Linnea030/Cat_Catering_Machine/Miniproject-Yixin Cao.pdf

## B31DD Report – Mini Project- Cat Catering Machine

Student Name: Yixin Cao
Student Number: H00315680

### 1.0 Project introduction

At present, young people are often too busy working overtime to take care of their pets. And in a long trip inconvenient to take the cat, will throw a lot of food. The grain is thus susceptible to damp spoilage. Cats get sick, too. Hence, young people do not have enough time to take care of their pets due to busy work and other reasons, so I developed an Arduino-based cat catering machine. There is timing feeder, and a toy module to the feeder, which can fully help owners to play with their pets. The whole project has four modes.

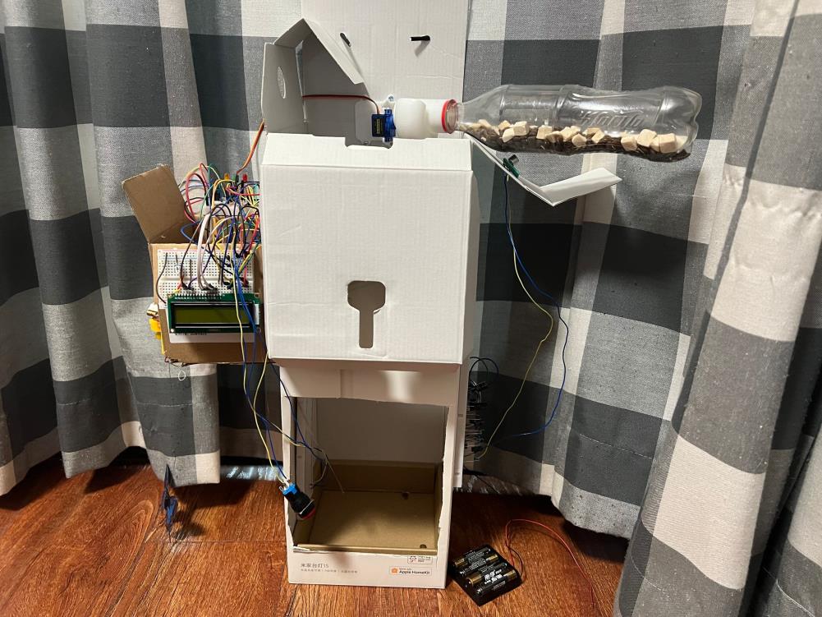
[picture p1: figure]

Figure 1 Machine structure overall
Here some components are needed, such as Arduino, motor, servo, and so on. Besides, there are some modules that did not used in class, such as LM393 and laser.

Table 1 Components used
Components | Number
Arduino uno | 1
Jumper | ∞
Motor | 1
laser | 3
L293D | 1
resister | 2
16*2LCD | 1

switch | 2
Breadboard | 4
Servo | 1
LM393 Soil moisture detection | 1
3D Print items | 2

### 2.0 Functionalities

There are four modes of this machine. The First mode is the playing mode, which is selected according to the pet's toy preferences (After investigation found that many cats and dogs like to chase laser). And because cats and dogs have the nature of hunting, so that this mode also have a module of flying butterfly which can help them train the skills of hunting. This little butterfly is connected to the motor by a wire, and we can use a potentiometer to adjust the speed of the motor and a button to control the direction of rotation. When the motor starts, the module appears to have a small butterfly flying around the device. The module has three laser generators that then shoot lasers at the ground at intervals of 1 seconds to 1s, because the laser is random, it can fully achieve the purpose of playing with pets.

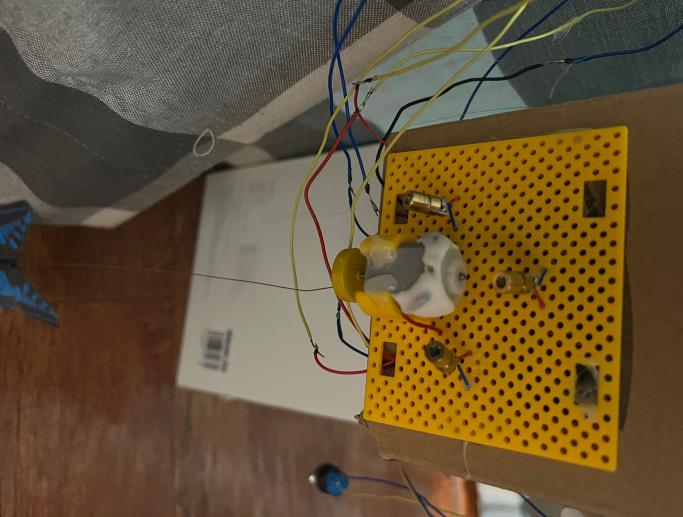
[picture p2: figure]

Figure 2 Assembled pattern for modeA

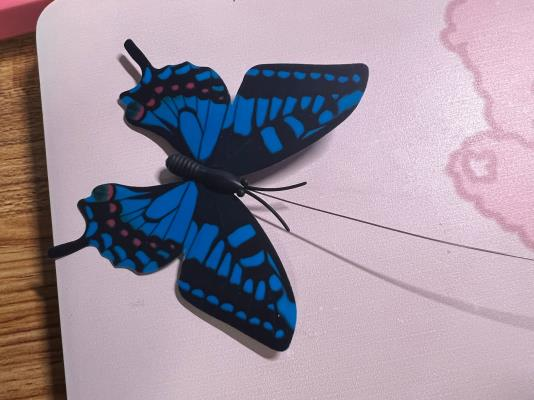
[picture p3: figure]
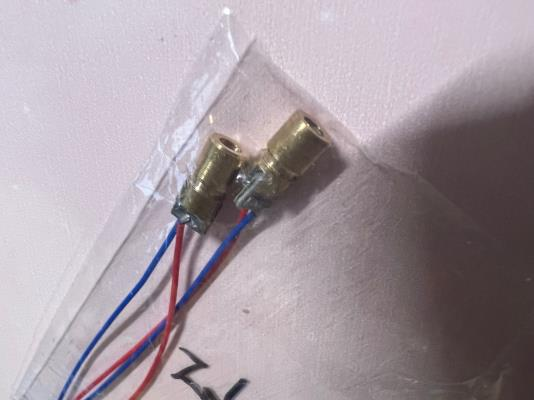
[picture p4: figure]

Figure 3 Toys and laser
The second mode is the feeding mode, which can feed the pets at a fixed time every day. Here are 4 time period can be set, that is, one hour, two hours, three hours and four hours. For convenience, here timer is set 1s instead of 1 hour. You can set the interval time for the feeding module to feed food at regular intervals, the specified interval is 1h, 2h, 3h and 4h, and the set time will be displayed on the 16*2 LCD screen.

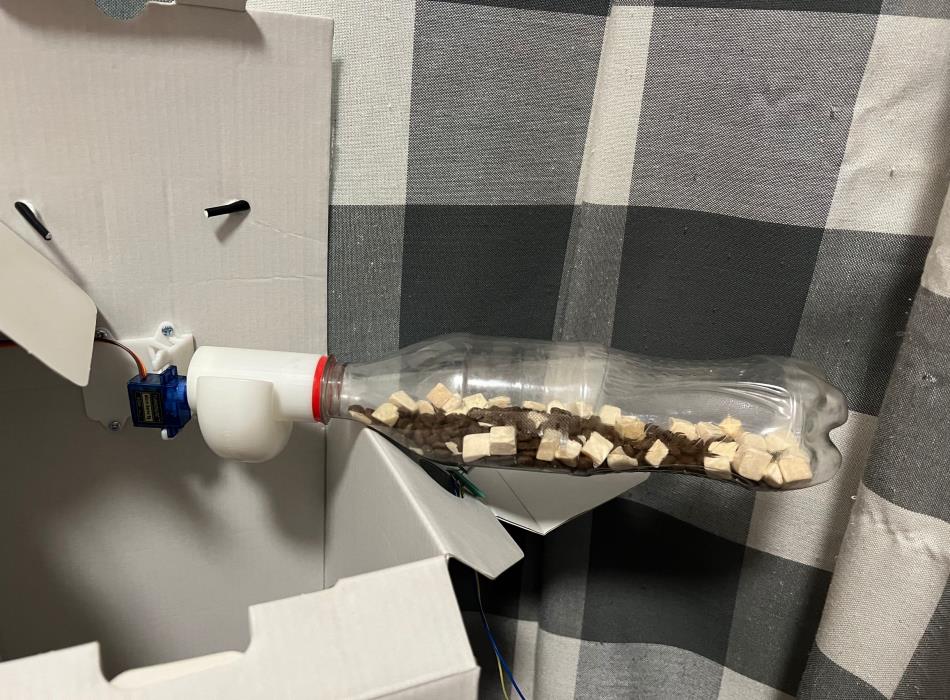
[picture p5: figure]

Figure 4 Assembled pattern for modeB
Third mode is noting mode. People can leave a note on LCD to remind something important. For example, leave a note about buying cat food, or clean the bowl of cat. And fourth mode is humidity detection mode. In this mode, the sensor detects in real time whether the cat's food is wet or not. If the humidity is lower than 500, it is judged to be wet and the LCD warns. This can prevent the cat from eating loose bowels.

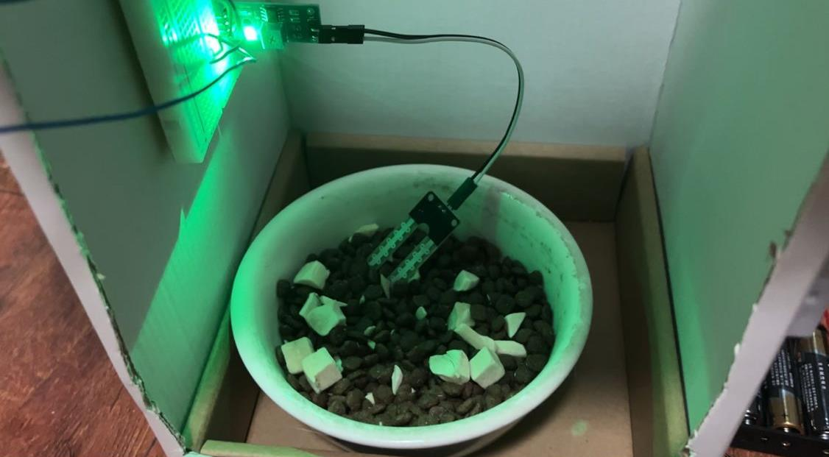
[picture p6: figure]

Figure 5 Assembled pattern for modeD
Finally, there is a speaker module, which can amplify your voice at any time. This module is designed by myself, with external power supply. You can speak through the microphone in real time, and the buzzer plays your voice.

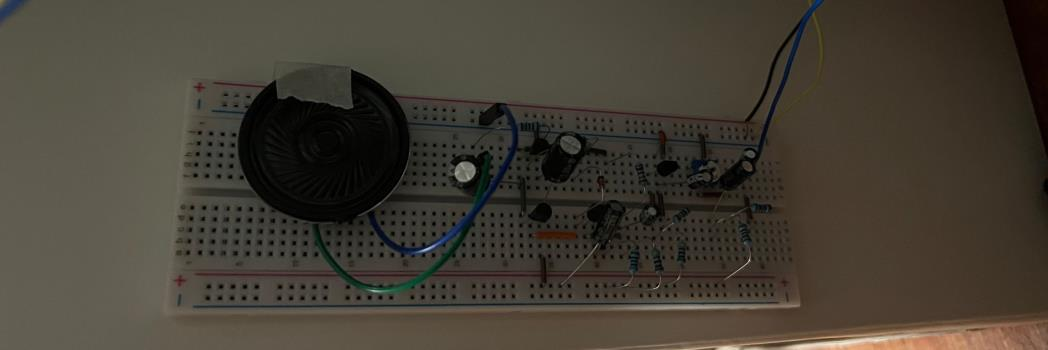
[picture p7: figure]

Figure 6 The speaker
Table 2 Function of each mode
Mode name | Mode code | Function
Playing mode | ModeA | Laser and toys play with cat
Feeding mode | ModeB | Feed cat at fixed time
Noting mode | ModeC | Leave note as reminder
Humidity detection mode | ModeD | Detect humidity of cat food
Speaker module | / | Amplify your voice

### 3.0 Arduino schematics diagram 3.1 Schematics diagram for speaker

R1 provides the bias voltage for the electret simplified MIC. The audio signal is added through C1 to RP1, which is the potentiometer for the volume control and can be used to adjust the output volume. C3 is the audio coupling capacitance. V1, R3 and R4 form a typical voltage parallel negative feedback circuit. After amplification by V1, the audio signal is coupled to the push stage constituted by V2 through C5. R5 and R7 provide a stable operating point for V2, in which R7 is connected to the output midpoint voltage. V3, V4 composed of power amplifier, because V2 and push-pull tube V3, V4 is directly coupled, resistance R7 such connection, plays a deep negative feedback role, so that the circuit can work more stable. At the same time, R6 is the emitter feedback resistance of V2, which further ensures the stability of the static working point of the circuit. C6 is the emitter bypass capacitor of V2, which provides a path for THE AC signal, so that the AC signal is not affected by the lock. VD1, R8 and R9 are the load resistances of the collector V2. And diode VD1 certain temperature compensation function, ensure the circuit work stably.

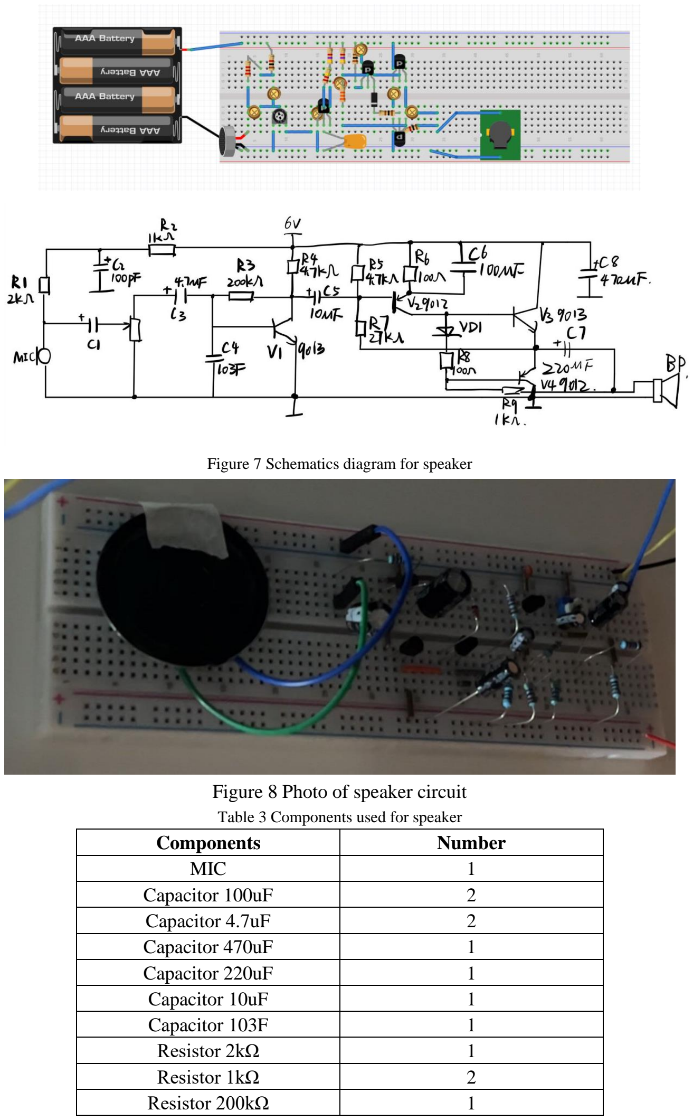
[picture p8: page 5]

Figure 7 Schematics diagram for speaker

Figure 8 Photo of speaker circuit

Table 3 Components used for speaker
Components | Number
MIC | 1
Capacitor 100uF | 2
Capacitor 4.7uF | 2
Capacitor 470uF | 1
Capacitor 220uF | 1
Capacitor 10uF | 1
Capacitor 103F | 1
Resistor 2kΩ | 1
Resistor 1kΩ | 2
Resistor 200kΩ | 1

Resistor 4.7kΩ | 2
Resistor 27kΩ | 1
Resistor 10kΩ | 1
Resistor 100Ω | 1
Triode 9013 | 2
Triode 9012 | 2
Diode 1N4148 | 1
Buzzer speaker | 1

### 3.2 Schematics diagram for ModeA

For mode A, using two switches and a potentiometer to control the overall program. The switch connected with Pin2 controls the direction of motor rotation. The switch connected with Pin3 controls the exit procedure. The potentiometer controls the motor speed. And use A3, A4, and A5 ports to control the light and dark of the laser. Lasers are replaced by LEDS here. ADC1 is used to control speed. So, potentiometer is connected to A1.

Table 4 Pins for H-bridge
H-bridge Pins number | 1 | 2 | 7 | 3 | 6 | 16 | 8 | 4 5 | //////
Pin means | 1,2 EN | 1A | 2A | 1Y | 2Y | Vcc1 | Vcc2 | Groun d (Pin4 Pin5) | Com mon groun d
Arduino pins | Pin6 (PD6) White | Pin13 (PB5) Purpl e | Pin12 (PB4) Purpl e | DC motor Yello w | DC motor Green | 5V Red | 9V Red | GND Black | 9V and 5V Grey

The Pin1 of the H bridge is connected to the Arduino's PD6 because the PD6 is the output of the PWM wave. Pin4 and Pin5 are connected to the ground of the Arduino. In addition, the Arduino GND is connected to the battery GND. Pin16 is connected to an Arduino 5V pin, and Pin8 to a 9V battery. Pin7 and Pin2 control the direction of the motor and connect PB4 and PB5. Pin6 and Pin3 are the average terminals of the dc motor, so they are connected to the DC motor. Pin16 is connected to an Arduino 5V pin, and Pin8 to a 9V battery.

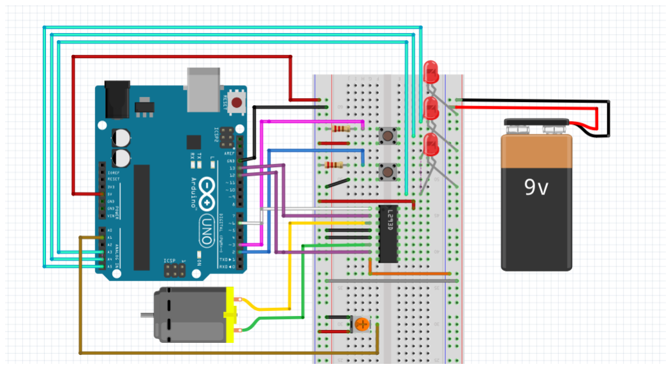
[picture p9: figure]
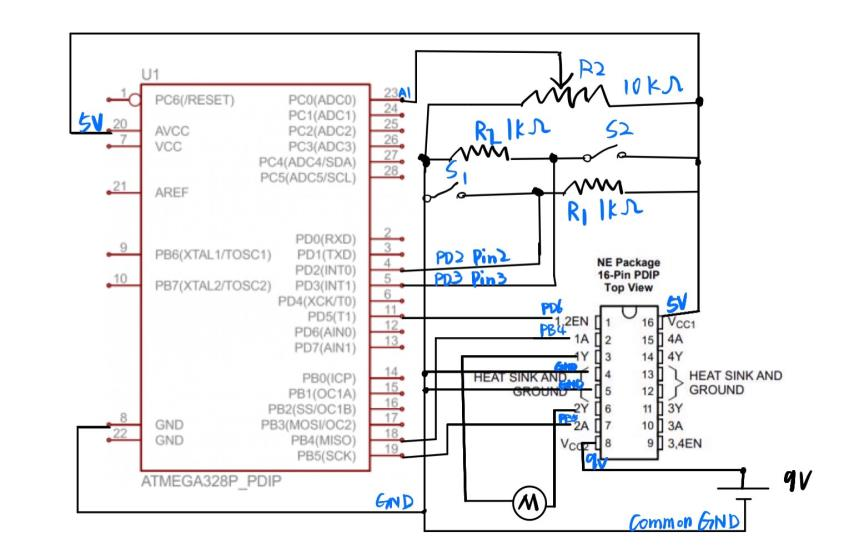
[picture p10: figure]

Figure 9 Schematics diagram for ModeA Table 5 Pins for modeA
Output | Pin6 (PD6) White | Pin12 (PB4) Purple | Pin13 (PB5) Purple
Output laser | A3(PC3) Light blue | A4(PC4) Light blue | A5(PC5) Light blue
Interrupt pin | Pin2 (PD2) Blue
Input | Pin3 (PD3) Pink | A1(PC1) Brown
Power | 5V Red | GND Black
Resistor | 1k Ω for switch

### 3.3 Schematics diagram for Mode

For mode B, using two switches to control the overall program. The switch connected with Pin2 controls the set time of servo rotation. The switch connected with Pin3 to controls the change time and quit the mode.

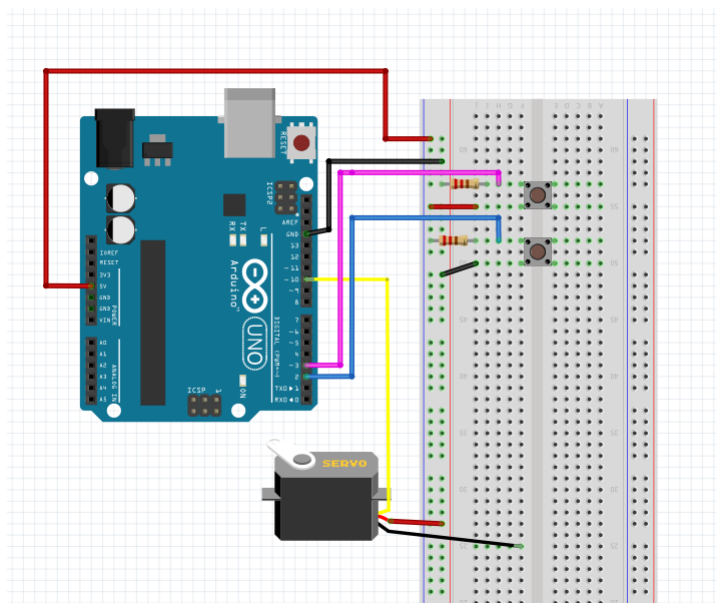
[picture p11: figure]
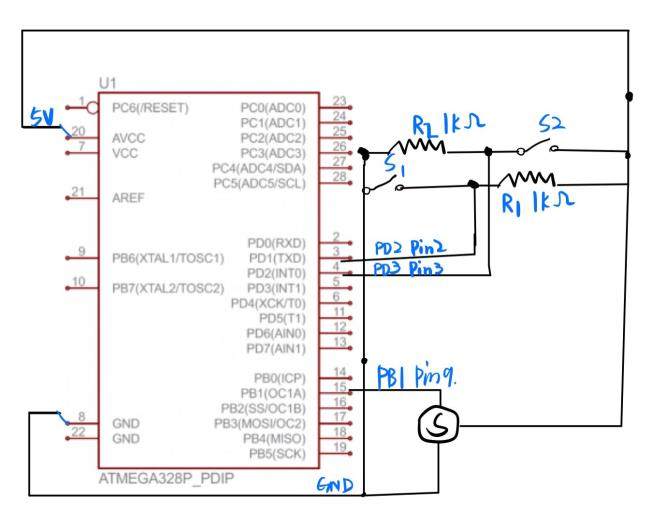
[picture p12: figure]

Figure 10 Schematics diagram for ModeB Table 6 Pins for modeB
Output | Pin9 (PB1) Yellow
Interrupt pin | Pin2 (PD2) Blue
Input | Pin3 (PD3) Pink
Power | 5V Red | GND Black
Resistor | 1k Ω for switch

### 3.4 Schematics diagram for ModeC

For mode C, using one switch to control the overall program. The switch connected with Pin2 controls to quit the mode. Here using 4-bit mode.
For LCD, the D4-D7 pins on the LCD are used to send and receive data. So, they connect PD4, PD5, PD7, and PB3 on Arduino, respectively. LCD grounding Connects to Arduino GND. Vss and Vcc can power the LCD and connect GND and 5V in Arduino. VEE is a pin that uses the potentiometer's voltage to control LCD contrast. This voltage is between 0 and 5 volts. The RW pins control whether the Arduino sends or receives data, and connect to GND so that it always receives data. Enable pins are used to activate pin receive and send. So, connect it with PB2 of the Arduino. The RS pin controls register selection, i.e.RS=1, loaded data is stored in the data register, RS=0, loaded data is stored in the command register. This is connected to PB0 on Arduino.

Table 7 Pins for ModeC
LCD Output | Pin7 (PD7) Yellow | Pin11 (PB3) Yellow | Pin5 (PD5) Yellow | Pin4 (PD4) Yellow
Output for enable and write | Pin8 (PB0) Green | | Pin10 (PB2) Blue
Power | 5V Red | | GND Black
Interrupt pin | Pin2 (PD2) Blue
Potentiometer | 5V Red | GND Black | VEE Pink

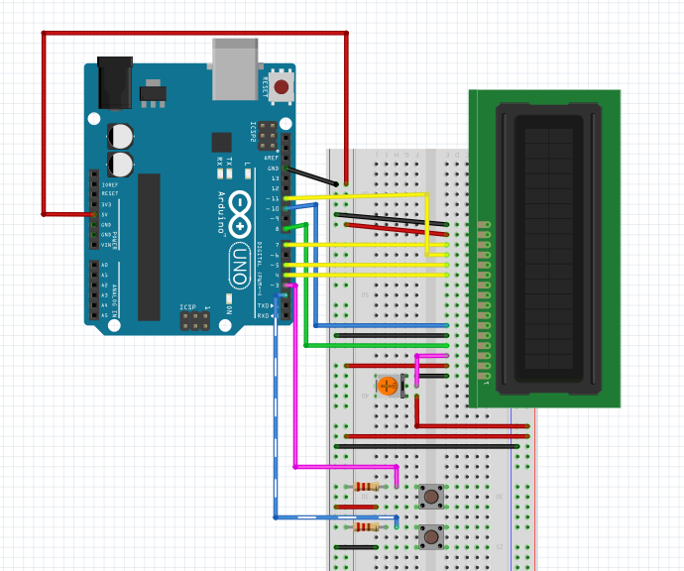
[picture p13: figure]
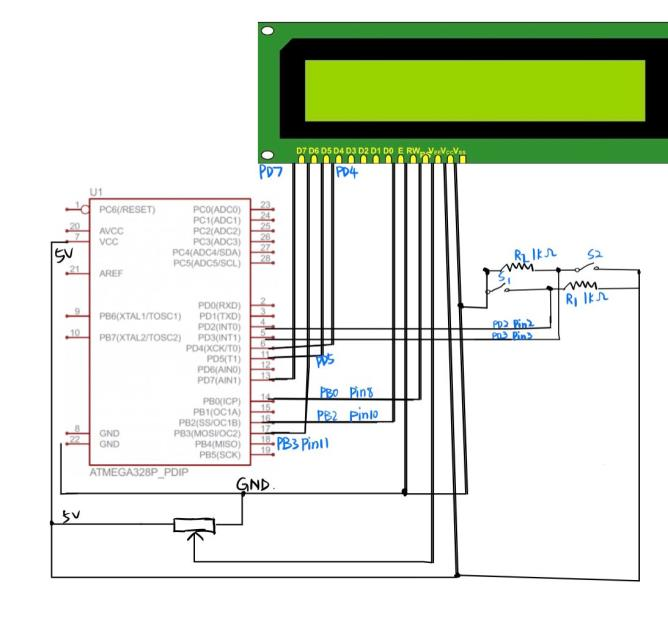
[picture p14: figure]

Figure 11 Schematics diagram for ModeC
Table 8 Pins for LCD
Vss | Vcc | VEE
/Vo | RS | RW | Enable | LED(G ND)

LED(5
V)

GND
Black

5V
Red

Potenti
ometer
Pink

Pin8
(PB0)
Green

GND
Black

Pin10
(PB2)
Blue

GND
Black 5V Red

### 3.5 Schematics diagram for ModeD

For mode D, using one switch to control the overall program. The switch connected with Pin2 controls quit the mode. Using ADC0 to get data from LM393.

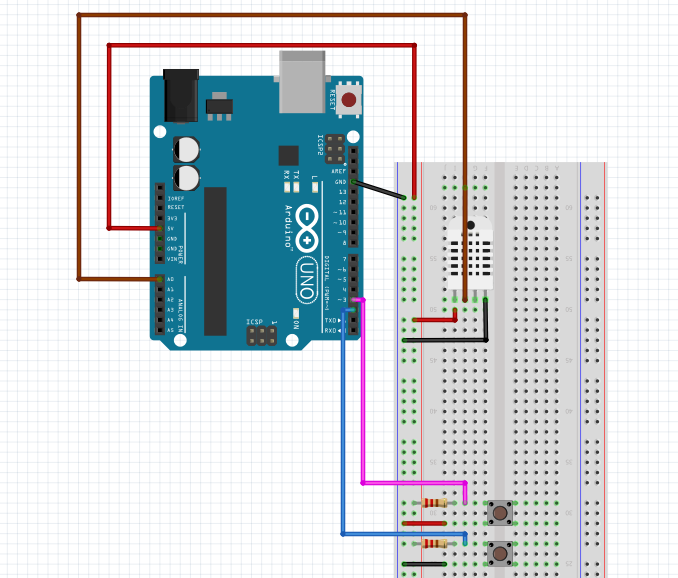
[picture p15: figure]
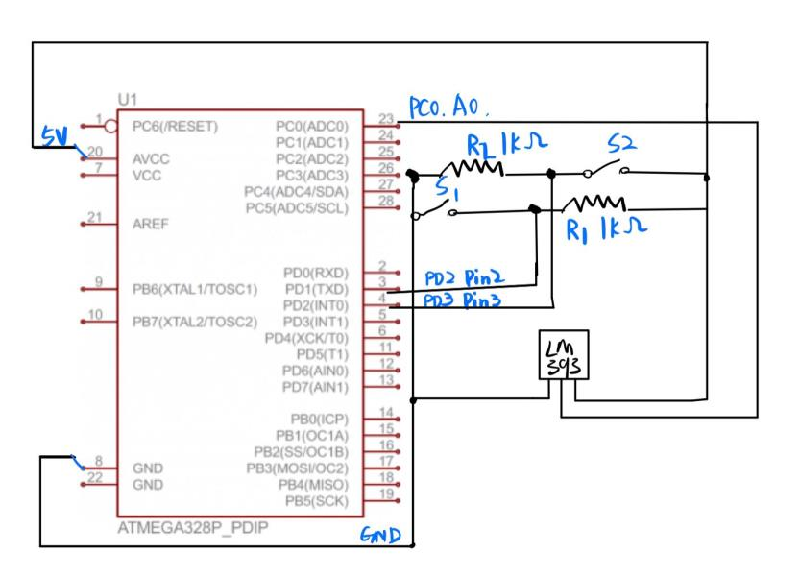
[picture p16: figure]

Figure 12 Schematics diagram for ModeD

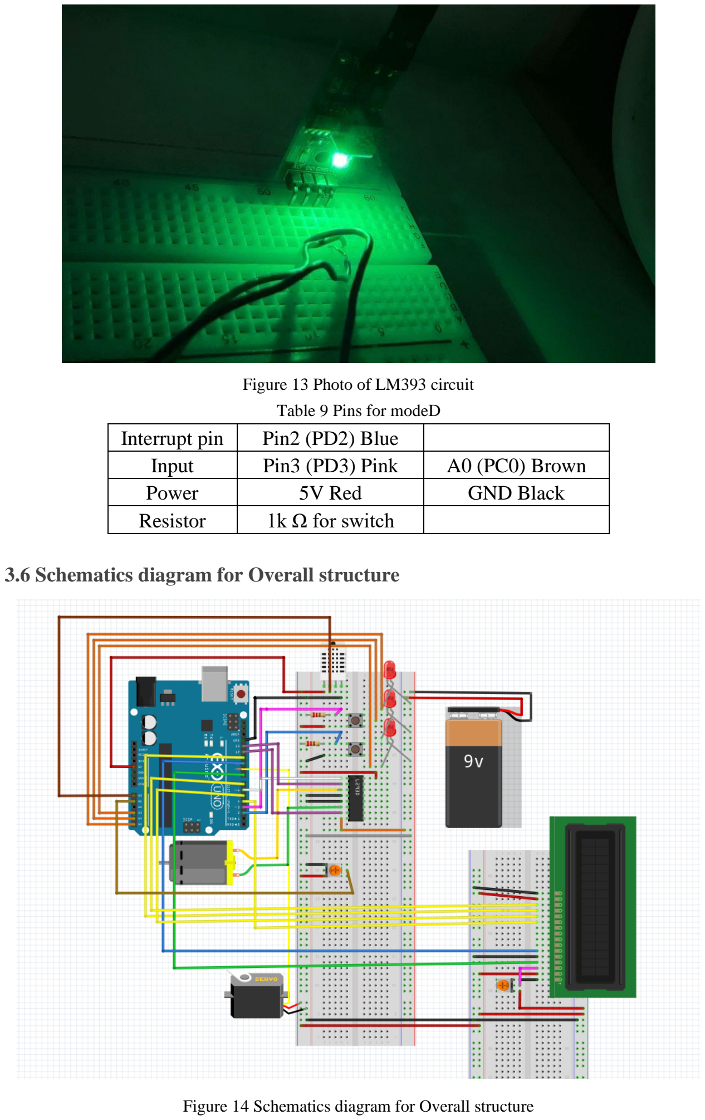
[picture p17: page 11]

Figure 13 Photo of LM393 circuit Table 9 Pins for modeD
Interrupt pin | Pin2 (PD2) Blue
Input | Pin3 (PD3) Pink | A0 (PC0) Brown
Power | 5V Red | GND Black
Resistor | 1k Ω for switch

### 3.6 Schematics diagram for Overall structure

Figure 14 Schematics diagram for Overall structure

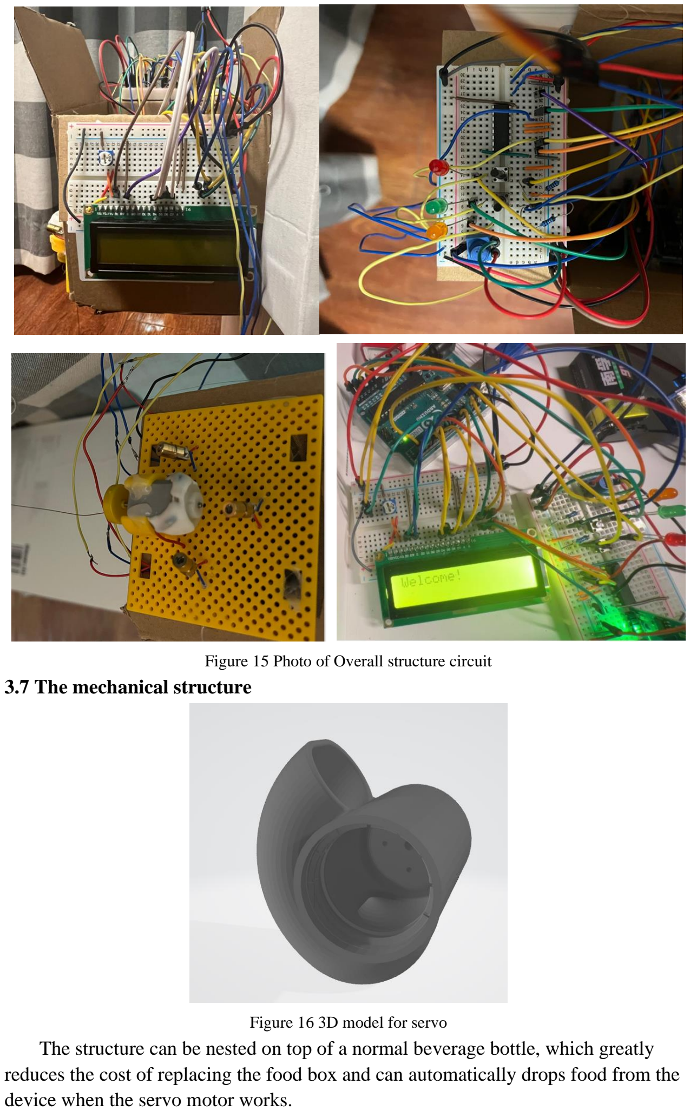
[picture p18: page 12]

Figure 15 Photo of Overall structure circuit

### 3.7 The mechanical structure

Figure 16 3D model for servo
The structure can be nested on top of a normal beverage bottle, which greatly reduces the cost of replacing the food box and can automatically drops food from the device when the servo motor works.

The whole machine is attached to a cardboard box. The motor and laser are fixed to the hole plate (See 3.7). Other circuits are fixed to the breadboard. There was an opening at the bottom of the box for the cat to eat in.
And switches are changed into switches has long button. This is very convenient for user to press.

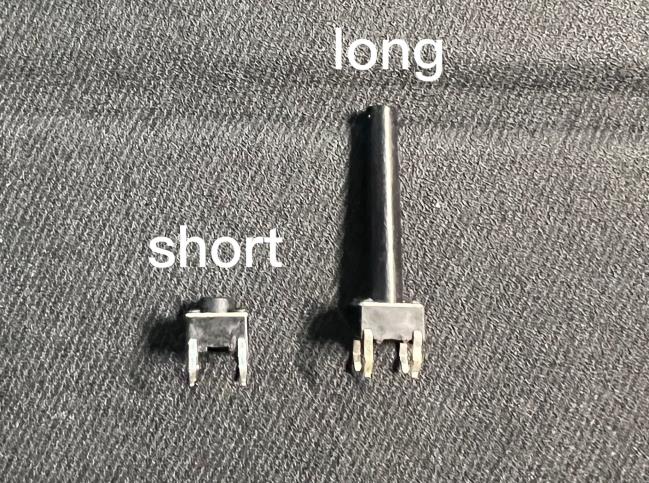
[picture p19: figure]

Figure 17 Switches used
The motor and laser are fixed to the hole plate. The laser has two wires, one is GND and the other is positive.

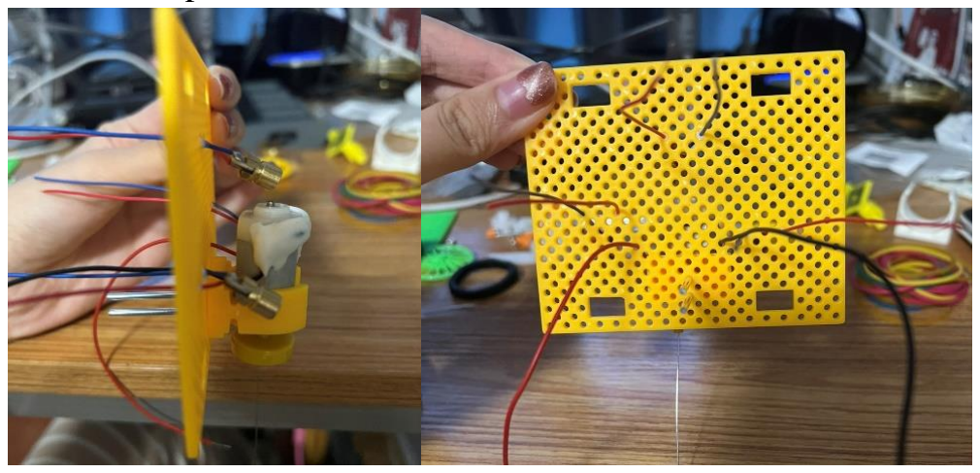
[picture p20: figure]

Figure 18 Motor is fixed on a board

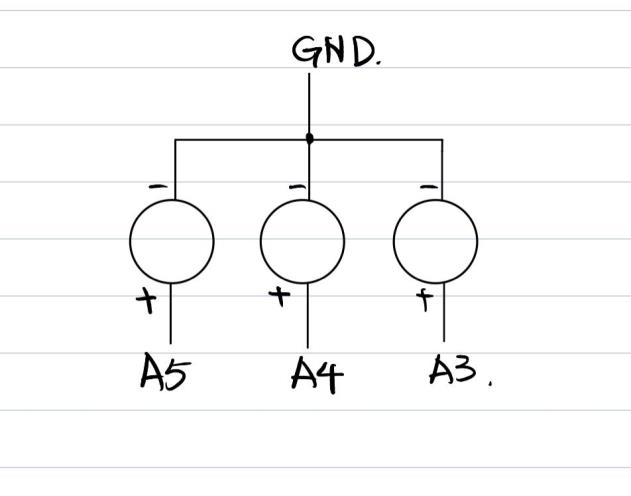
[picture p21: figure]

Figure 19 Pins for lasers

As the wire was not long enough, part of the circuit and parts were welded.

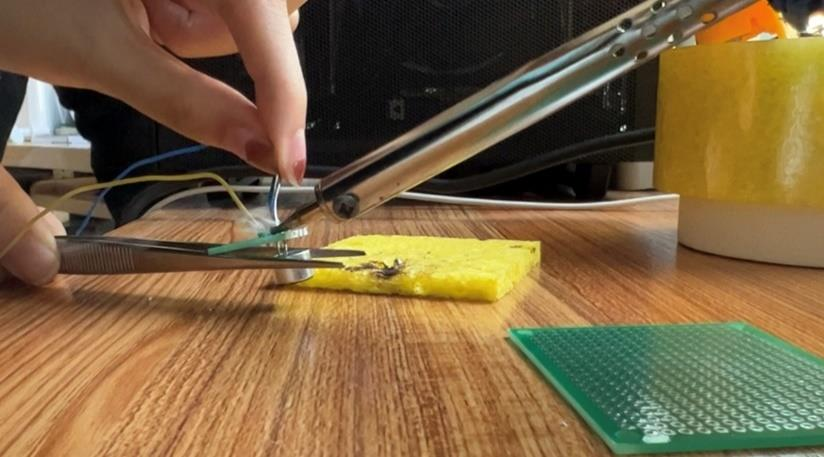
[picture p22: figure]
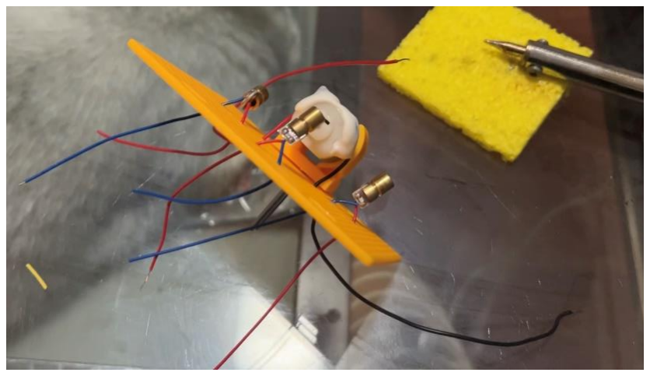
[picture p23: figure]

Figure 20 The welding equipment

### 4.0 Explanation of techniques used

Here, all the techniques that learned at class are used. Input and output are used to connect Arduino and other parts. ADC0 and ADC1 are used to get data from LM393 and potentiometer, respectively. Motor is used in ModeA to rotate the butterfly to play with cat. Servo is used in ModeB to rotate the bottle to feed cat. Interrupt is used to quit mode and stop the machine for all modes, which will show in a single module in this report. USART is used in each mode to communicate with PC and send some reminder to PC. This will also be shown in a single module. For LCD, it is used in each mode to remind which mode that is running. And especially in ModeC, LCD can get string from PC and display it. For timer, it is used in ModeB to achieve some delay. Here are details about them.

### 4.1 Explanation of techniques used in ModeA

In ModeA, motor is controlled by one switch and a potentiometer. This is quite similar to Lab2. Switch is used to change direction and potentiometer is used to change speed. Pin6 is used to generate PWM wave. So, OCR0A is used. Here are some formular to calculate OCR0A to control the speed. Here non-inverting mode and fast PWM mode are used. So, the duty cycle can be calculated:

N: prescaler can be calculated, if generate 61.04Hz PWM wave.

For 1024 prescaler and timer0, set WGM02=0, CS02=1 CS01=0 CS00=1. So, TCCR0B = 00000101=0x05.
For non-inverting mode, set COM0A1=1, COM0A0=0. So, TCCR0A = 10000011=0x83. For fast PWM mode, set WGM02=0, WGM01=1, WGM00=1. And here ADC1 is used to set the OCR0A at any time when in mode A. PinA1 (ADC1) gets the voltage value of potentiometer. For this 10-bit convert, the resolution of ADC1 can be obtained.

The OCR0A need in the range of 0-255. So, get the factor to use adjust the range. The ADC1 initial range is:

Besides, to change direction of motor, using H-bridge to control. When pressing the button, detect which direction pin is on. Turn off the current direction pin by setting it Low, and turn on the direction pin which is off now by setting it High.
And here three laser is used to play with cat. A3, A4 and A5 are connected with these three lasers. And to make cat more confused and happier, these three pins’ output are random. Here using rand() function to generate random number. And use srand() function to select a seed for random generating. This can make sure the random number is not a pseudo random sequence.

### 4.2 Explanation of techniques used in ModeB

For ModeB, timer and servo are used. Timer is used to achieve delay. Here a delay for 1s, 2s, 3s and 4s are used. Because timer is used to generate PWM wave, timer0 is used to set delay. Here are details for calculated.

Step1: Calculate period for original.

Step 2: Calculate period when using 1024 prescaler. For 1024 prescaler, set TCCR1B=0x05=5. And normal mode is used, so set TCCR1A=0x00=0.
Step 3: Calculate the number of machine cycles for delay 1 ms.

Step 4: Calculate the time delay when number of machine cycles is 255 Time delay max = Periodactual ∗ 255 = 0.01632s
Step 5: Calculate loop:
Loop for 1s delay = 1s/Time delay max ≈ 61.27 ≈ 61 Loop for2s delay = 2s/Time delay max ≈ 122.55 ≈ 123 Loop for 3s delay = 3s/Time delay max ≈ 183.82 ≈ 184 Loop for 4s delay = 4s/Time delay max ≈ 245.10 ≈ 245

Table 10 Loop for delay
Time delay | Loop number
1s | 61
2s | 123
3s | 184
4s | 245

For servo, set it to rotate 180 degrees at each time. And hold this position for 1 second, then back to 0 degree.
Using fast PWM mode 14 and timer1 control servo system. ICR1 has a maximum value of 0xFFFF. Here ICR1 is set to 40000. Therefore, the frequency wave generated in fast PWM mode can be calculated:

Duty cycle of PWM can be calculated:

Theoretically, the angle corresponding to the control servo angle is as follows.

Table 11 The parameters of servo
Angle(degrees) | -90(0) | -45(45) | 0(90) | 45(135) | 90(180)
Pulse width | 1ms | 1.25ms | 1.5ms | 1.75ms | 2ms
Duty cycle | 2.5% | 5% | 7.5% | 10% | 12.5%
The servo system requires a PWM wave with a period of 20ms. So, T is equal to 20 milliseconds. Here are the steps to calculate the register values.
Find N: prescaler:

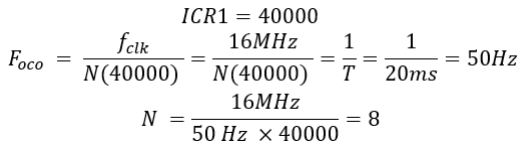
[picture p24: figure]

Find OCR1A for -90 and 90 degree:

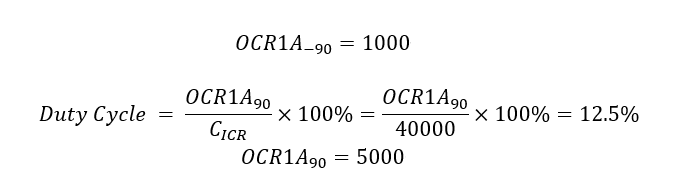
[picture p25: figure]

Table 12 Value of OCR1A
Angle(degrees) | -90(0) | 90(180)
OCR1A | 1000 | 5000
OCR1A offset | 1100 | 4900
Moreover, switch is used to set time. When pressing switch, add one to the global variable C. And using C to select a case from switch function to achieve the time delay change. There are four length of time delay to select. So, only need four different C. Set C equal to 0 when C is larger than 4.

### 4.3 Explanation of techniques used in ModeC

For ModeC, LCD and USART are used. LCD is used to display the note from PC. USART are used to set communication between PC and Arduino. Here 4-bit mode of LCD is used to save the pins.
Here Baud rate is 9600 bps. Asynchronous Normal mode (U2Xn = 0) is used. Now BAUD_PRESCALLER can be obtained.

X is the value of UBRR register that is USART baud rate register.

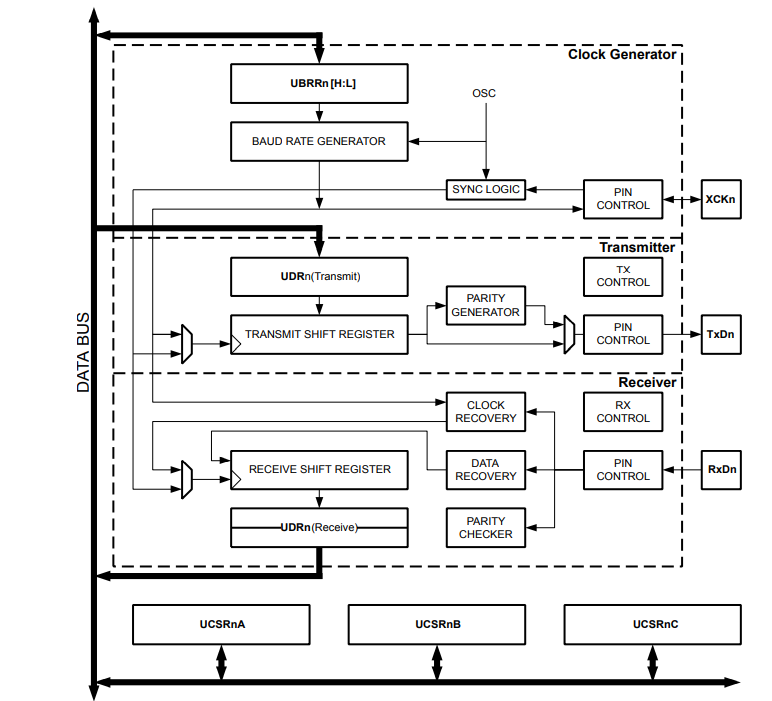
[picture p26: figure]

Figure 21 USART Block

Figure 22 Data Visualizer setting
Select \r\n to the sent string, so that stop character can be detected.

Table 13 Meanings of \n and \r

### 4.4 Explanation of techniques used in ModeD

For ModeD, LCD, ADC0, LM393 and USART are used. LCD is used to display the humidity value from LM393. USART are used to set communication between PC and Arduino. Here 4-bit mode of LCD is used to save the pins. LM393 is used to detect the humidity of cat food. ADC0 is used to get data from LM393.
When using ADC0, change MUX0 of setting.

PinA0 (ADC0) gets the voltage value of potentiometer. For this 10-bit convert, the resolution of ADC1 can be obtained.

The data of humidity has no need to adjust the range. So, use the ADC1 initial range 0-1023. When humidity is larger than 600, that means the cat food is dry. When humidity is smaller than 600, that means the cat food is wet, and Arduino will send “wrong” to LCD.
In terms of LM393, this is a sensor that detects humidity. It has its own potentiometer to regulate sensitivity. It determines humidity by measuring the electrical conductivity of the two probes. Because more water makes it easier to conduct electricity. It has four pins. One is Vcc, a 5V connected to Arduino. One is the GND connection ground. One is D0, which is a digital output pin that connects the alarm or indicator light. The last one is the A0 pin, which is the output voltage pin, that is, the output data pin. This pin needs to be connected to the ADC0 of Arduino.

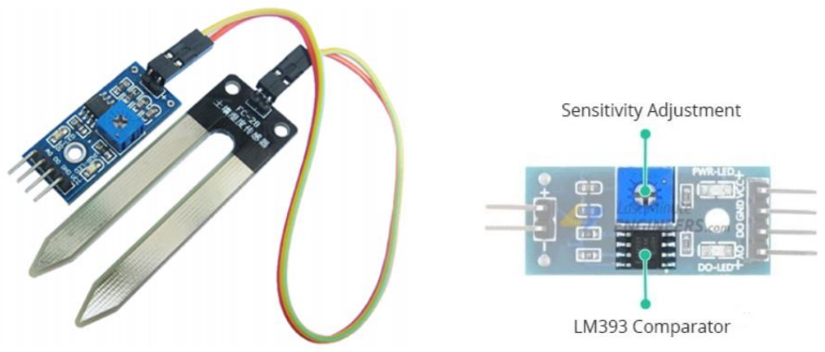
[picture p27: figure]

Figure 23 LM393A

### 4.5 Explanation of interrupt

In each mode, interrupt INT0 is used to quit the mode at any time. So, a pull-up register is used and switch is used. When press interrupt button, the LCD will be cleared and delay for 1s to reset the whole program. Then back to while(1) and waiting for mode select.

### 4.6 Explanation of USART

USART in this project has three functions.
Firstly, select mode. When sending “A”, the code will get into the ModeA. When sending “B”, the code will get into the ModeB. When sending “C”, the code will get into the ModeC. When sending “D”, the code will get into the ModeD.
Secondly, transmit information to PC. When get into a mode, it will send ModeX to PC. For example, when get into ModeA, it will send “ModeA” to PC. And when quit a mode, it will also send “Quit” to PC. And especially for ModeC, when sending a note from PC, it will send “Receive message” to PC, and send “Change message” later. Thirdly, when in ModeC, USART is used to transmit string from PC to LCD.

### 4.7 Pseudo-code

Here is the pseudo-code:

Pseudo-code for Task2 switch control speed
1. #define D4-D7 RS EN
2. #define BAUDRATE BAUD_ PRESCALLER 3.
4. in main event;
5. set_ output(PORTD and PORTB0 1);
6. USART_init();
7.
8. while(1){
9. if(A){
10. while(1){
11. Lcd4_Write_String(ModeA);
12. Motor rotate;
13. Speed change by potentiometer;
14. If switch on, change direction;
15. If interrupt on, Quit;
16. }
17. if(B){
18. while(1){
19. Lcd4_Write_String(ModeB);
20. Set time by press button;
21. servo rotate;
22. Delay by timer0;
23. If interrupt on, Quit;
24. }
25. if(C){
26. Lcd4_Write_String(ModeC);
27. while(1){
28. Lcd4_Clear();
29. stop USART send and receive;
30. Lcd4_Init();
31. Lcd4_Set_Cursor(1,3);
32. Lcd4_Write_String(string);
33. USART_init();
34. transform(string);
35. USART_putstring("Received data\n");// tips for terminal
36. _delay_ms(1000);
37. If interrupt on, Quit;
38. }
39. if(D){
40. while(1){
41. Lcd4_Write_String(ModeD);
42. Get ADC0 value from LM393;
43. If <600, send wrong to LCD;

44. If interrupt on, Quit;
45. }
46.
47. in interrupt event 0;
48. if (INT0){ //switch on
49. Lcd4_Clear();
50. delay();//delay 0.5s to prevent error caused by key jitter
51. }
52. return main event while(1);

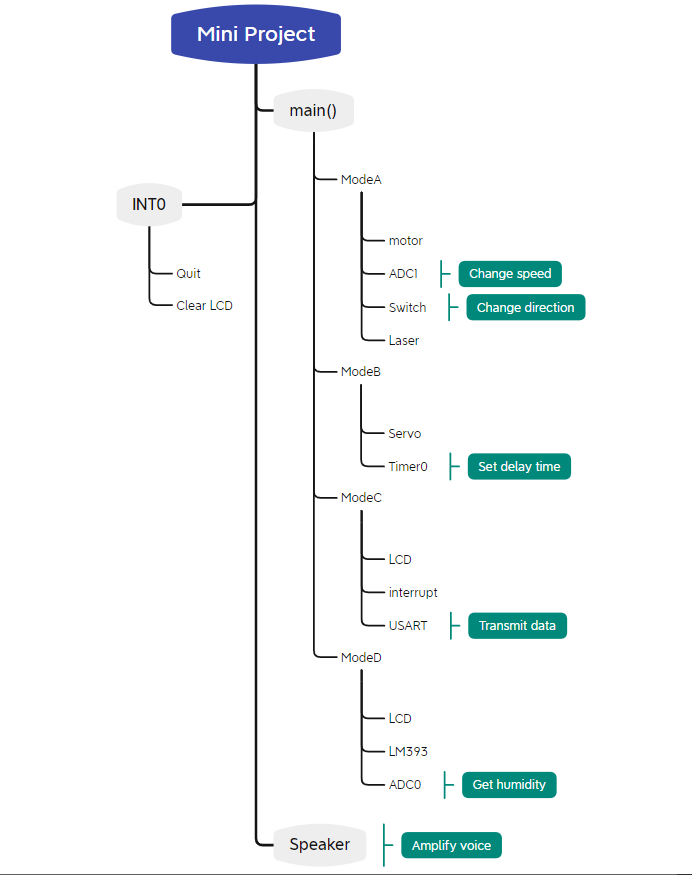
[picture p28: figure]

Figure 24 Flowchart of whole structure

### 5.0 Demo results (e.g., screenshots)

### 5.1 Demo results for LCD

When entering into each mode, LCD will display.

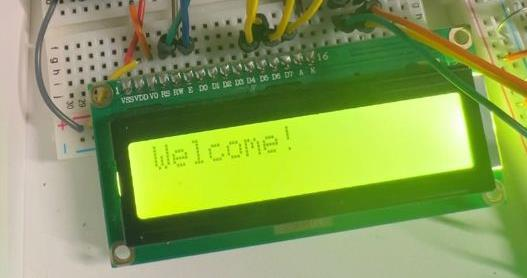
[picture p29: figure]
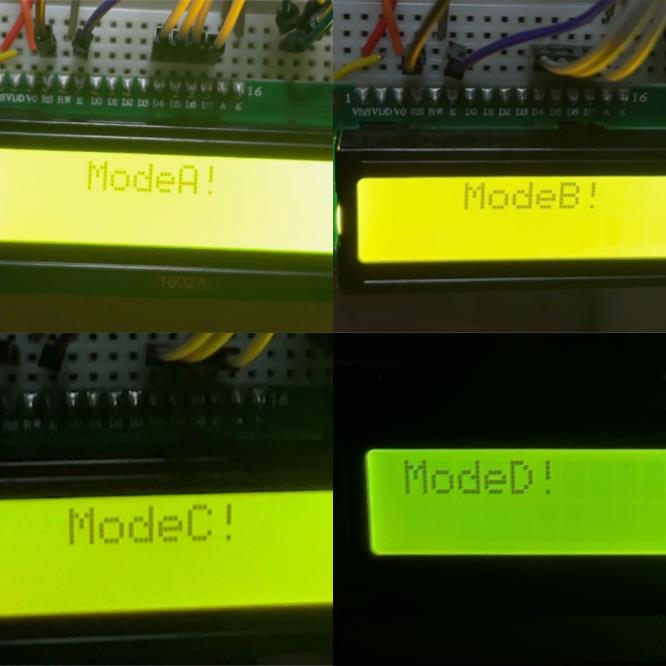
[picture p30: figure]

Figure 25 LCD display Mode
When in ModeB, selecting time, LCD will display.

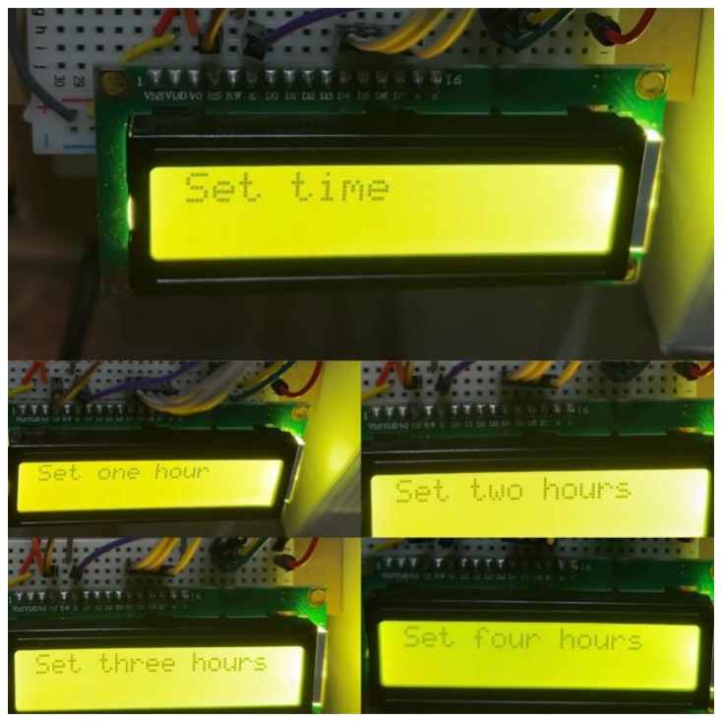
[picture p31: figure]

Figure 26 LCD display in ModeB

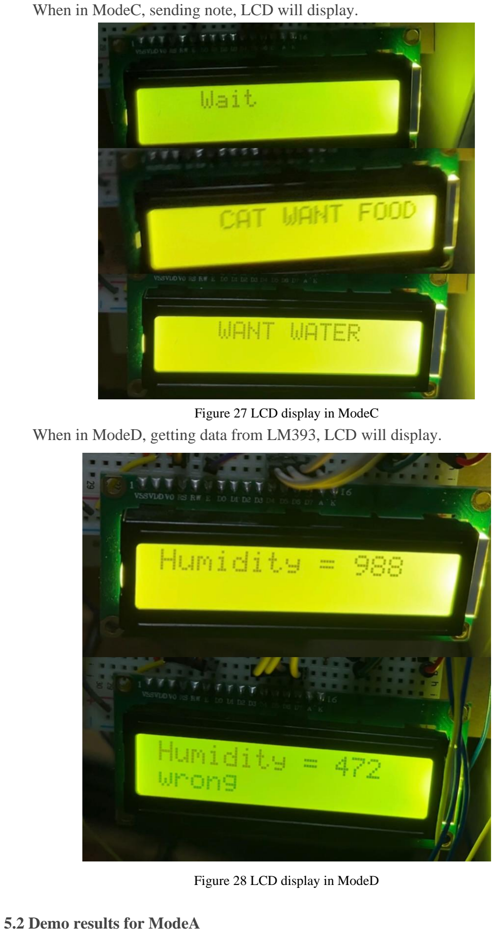
[picture p32: page 23]

When in ModeC, sending note, LCD will display.

Figure 27 LCD display in ModeC
When in ModeD, getting data from LM393, LCD will display.

Figure 28 LCD display in ModeD

### 5.2 Demo results for ModeA

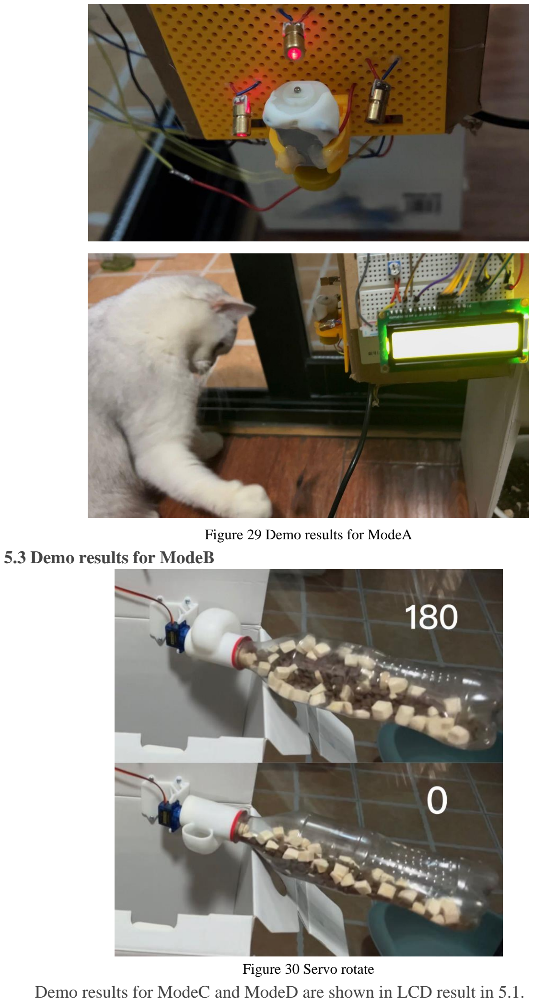
[picture p33: page 24]

Figure 29 Demo results for ModeA

### 5.3 Demo results for ModeB

Figure 30 Servo rotate
Demo results for ModeC and ModeD are shown in LCD result in 5.1.

### 5.4 Demo results for USART

When connecting Arduino, it will send “welcome to use” to PC. When entering into a mode, Arduino will send message to PC. When quitting a mode, Arduino will also send message to PC.

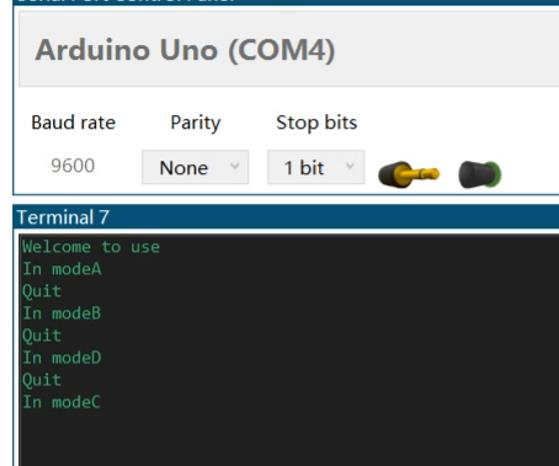
[picture p34: figure]

Figure 31 USART
When sending note from PC to Arduino, the Arduino will send reminder to PC to inform that message is received.

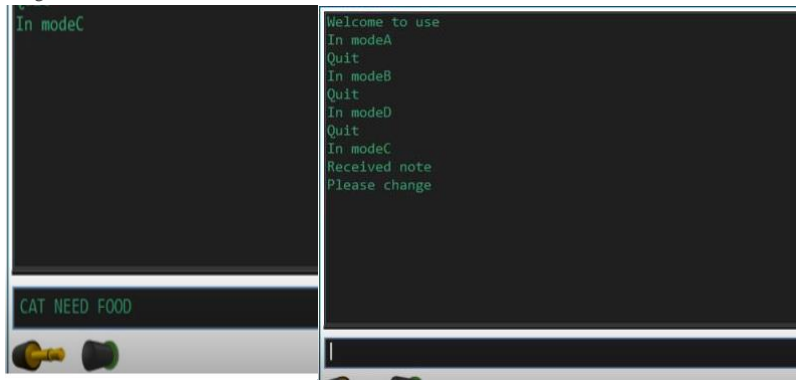
[picture p35: figure]

Figure 32 USART in ModeC

### 5.5 Method of use

Here four switches are used in the whole program. Here is picture of them. For S4, it is used to set the contrast degree of LCD.

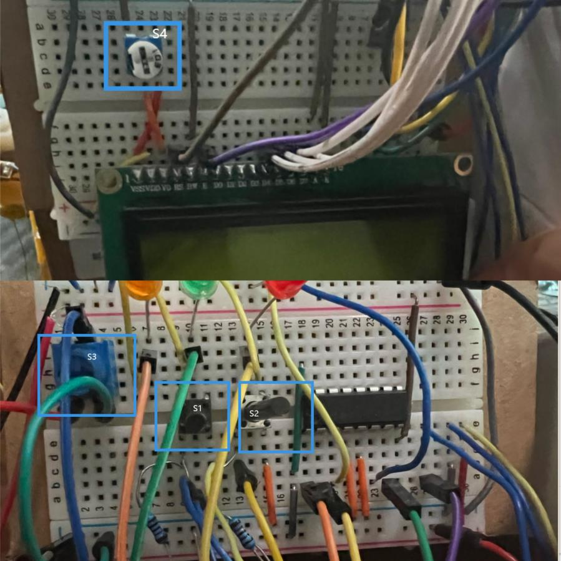
[picture p36: figure]

Figure 33 Switches control whole system
In ModeA, S1 is used to change direction of motor. And S3 is used to set the speed of motor. S2 is used to quit the mode.
In ModeB, S1 is used to change set time of timer0. And S3 is not used here. S2 is used to quit the mode.
In ModeC, S1 is not used here. And S3 is not used here. S2 is used to quit the mode.
In ModeD, S1 is not used here. And S3 is not used here. S2 is used to quit the mode.

### 6.0 Performance evaluation

Overall, the device conforms to the expected design and achieves the functional objectives, but there are still some areas that can be improved.
1. In the later stage, WiFi module can be added, and home intelligent LAN can be added, so that the device can be remotely controlled, such as remote setting time, remote recording and so on.
2. A camera can be added to the device so that the cat's condition can be monitored remotely in case of accidents. Bread boards can be replaced with welded hole boards. The whole project will be stronger and less susceptible to damage.
3. Stronger wires can be used to prevent the circuit from becoming loose. Bread boards can be replaced with welded hole boards. The whole project will be stronger and less susceptible to damage.

4. A stronger material can be chosen for the frame so that it could not be damaged by the cat's playful behavior during their daily activities. For example, acrylic sheet is beautiful and strong.
5. Switch can be replaced by button, in order to press remote and easily.

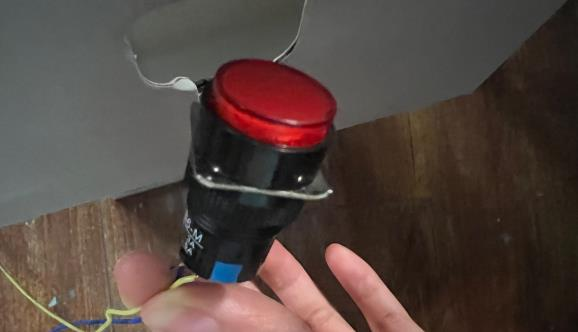
[picture p37: figure]

Figure 34 Button can be used

### 7.0 Source code

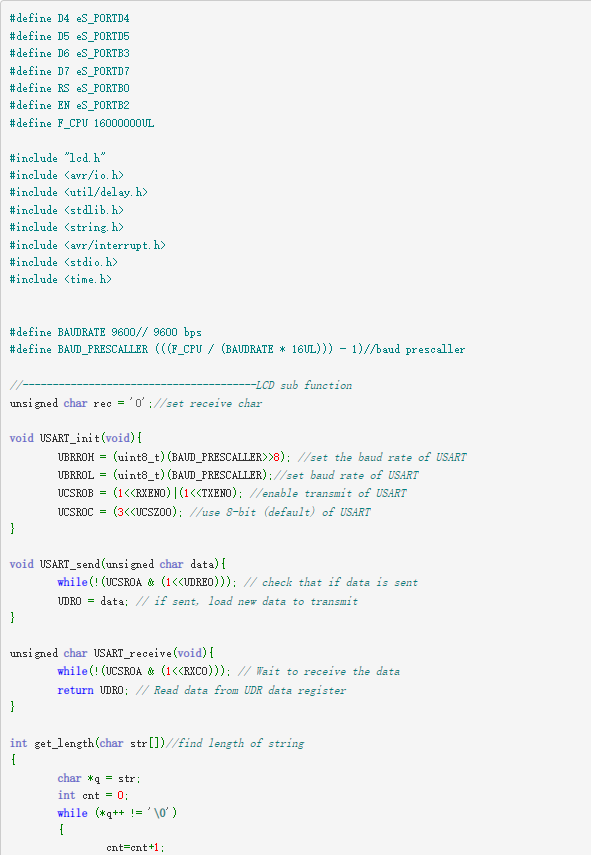
[picture p38: figure]

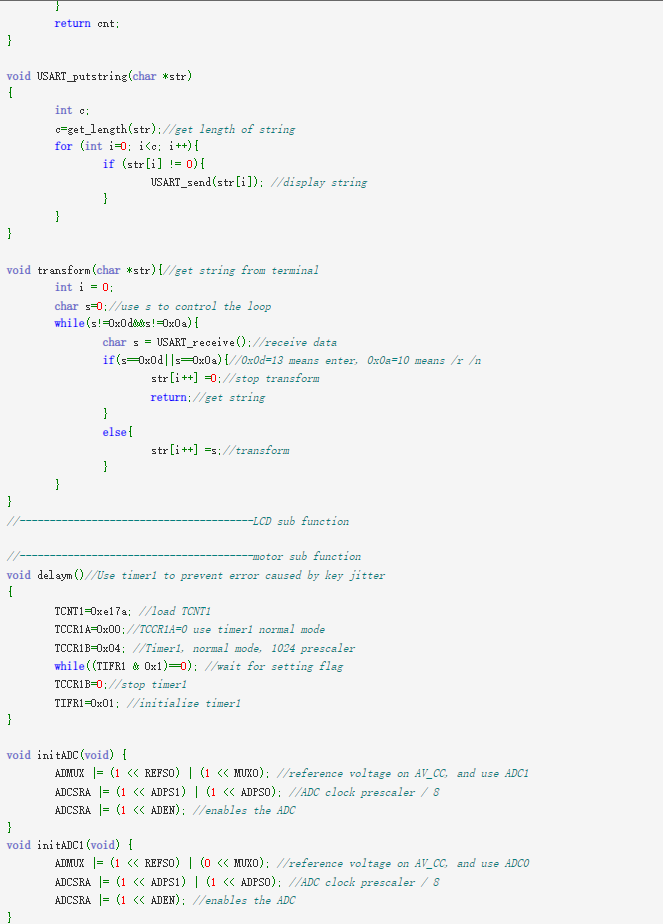
[picture p39: figure]

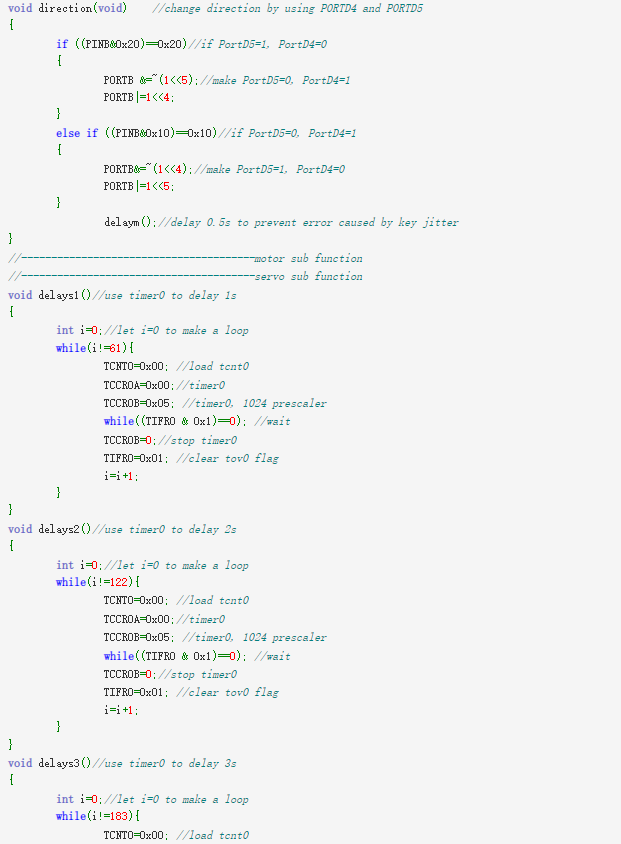
[picture p40: figure]

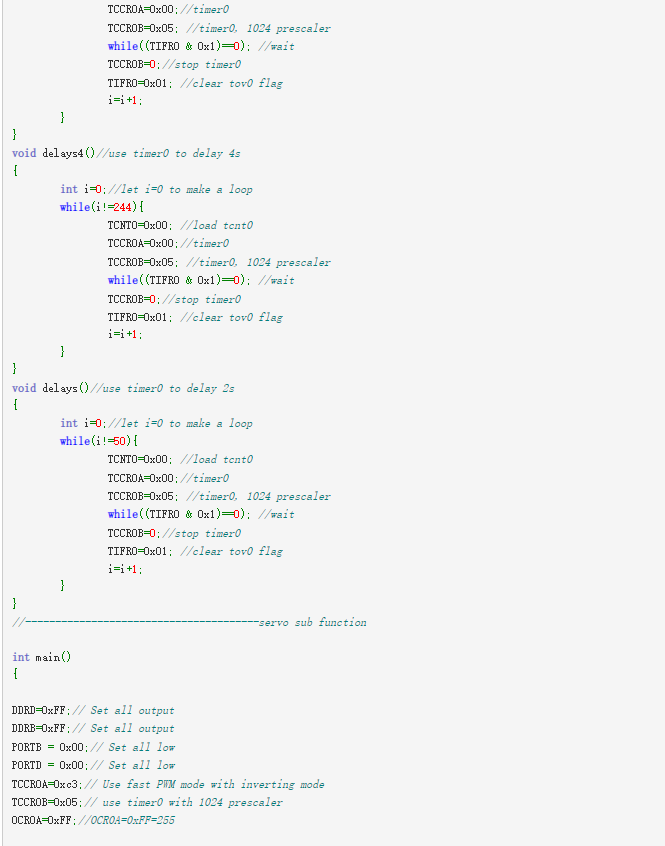
[picture p41: figure]

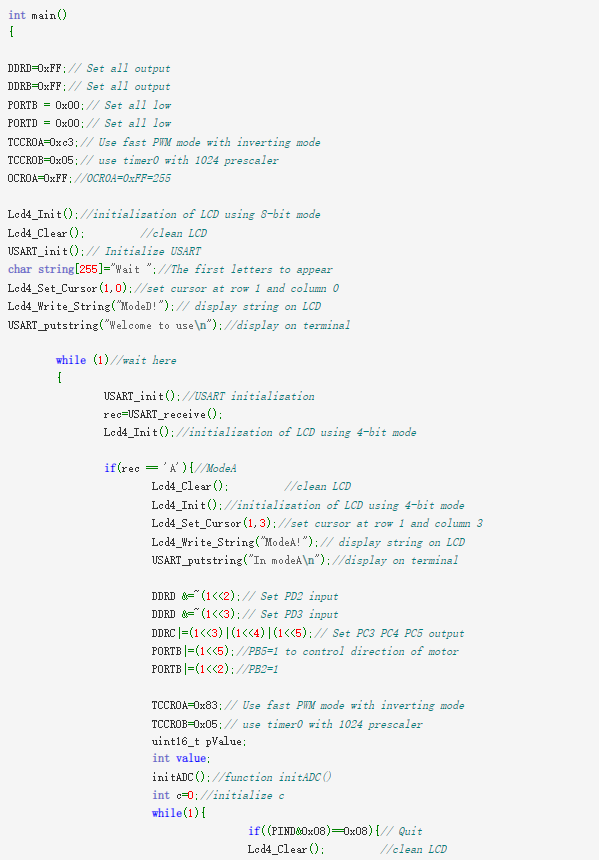
[picture p42: figure]

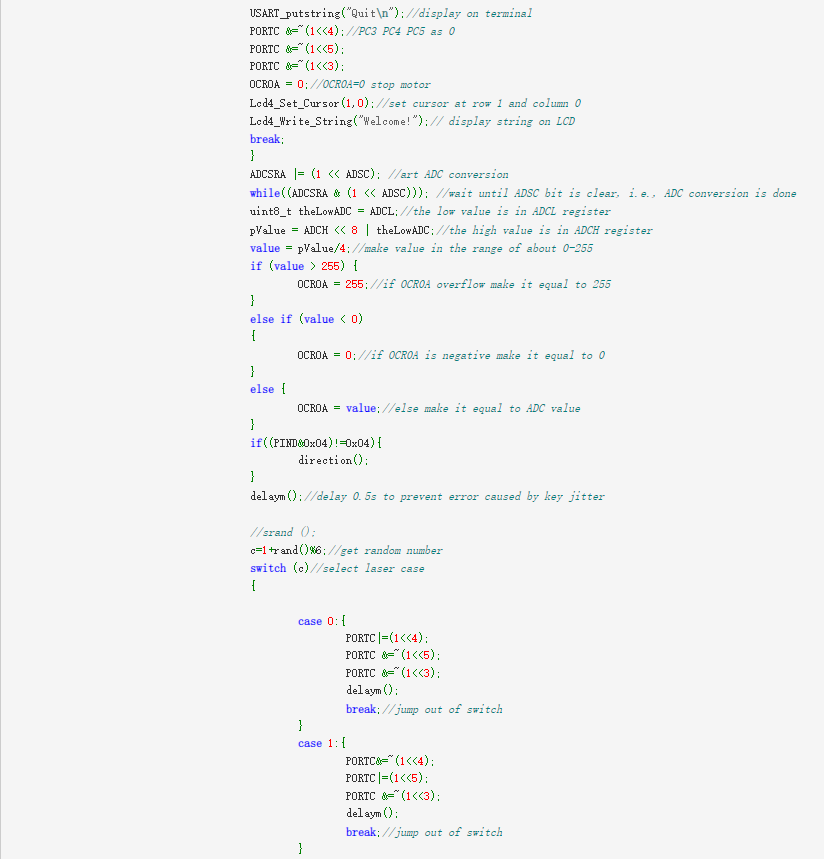
[picture p43: figure]

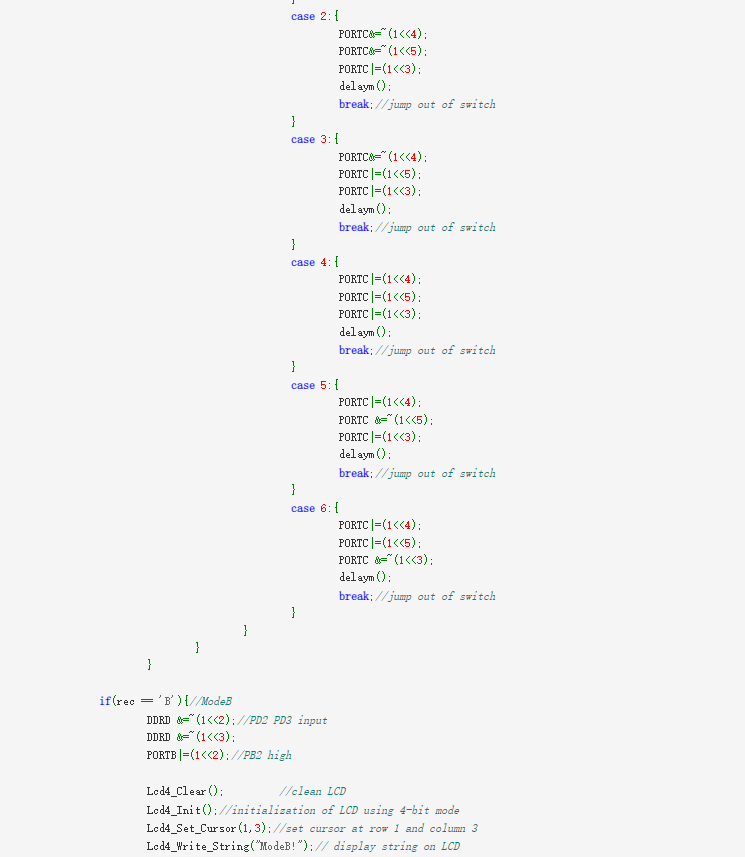
[picture p44: figure]

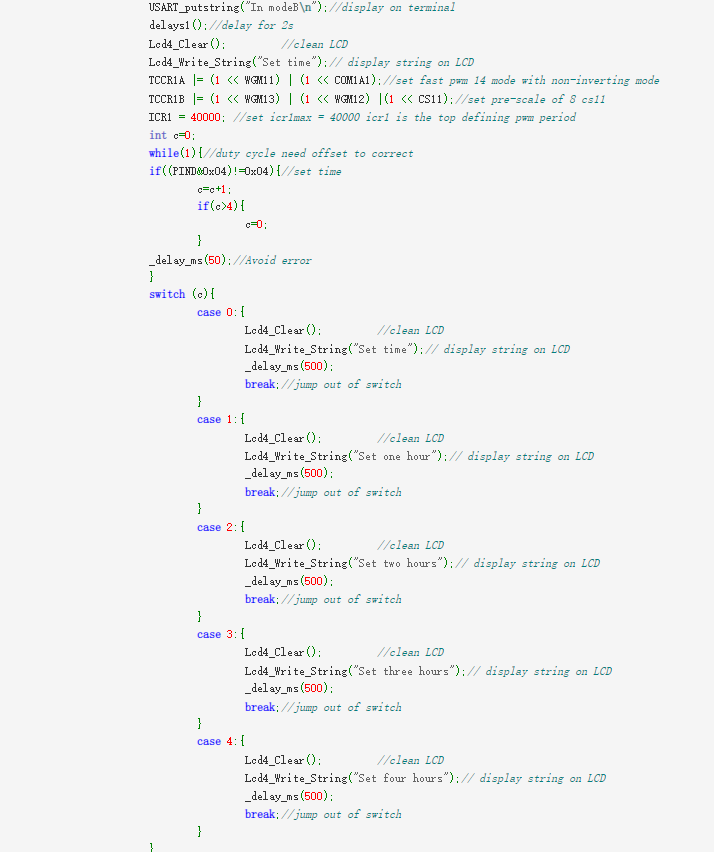
[picture p45: figure]

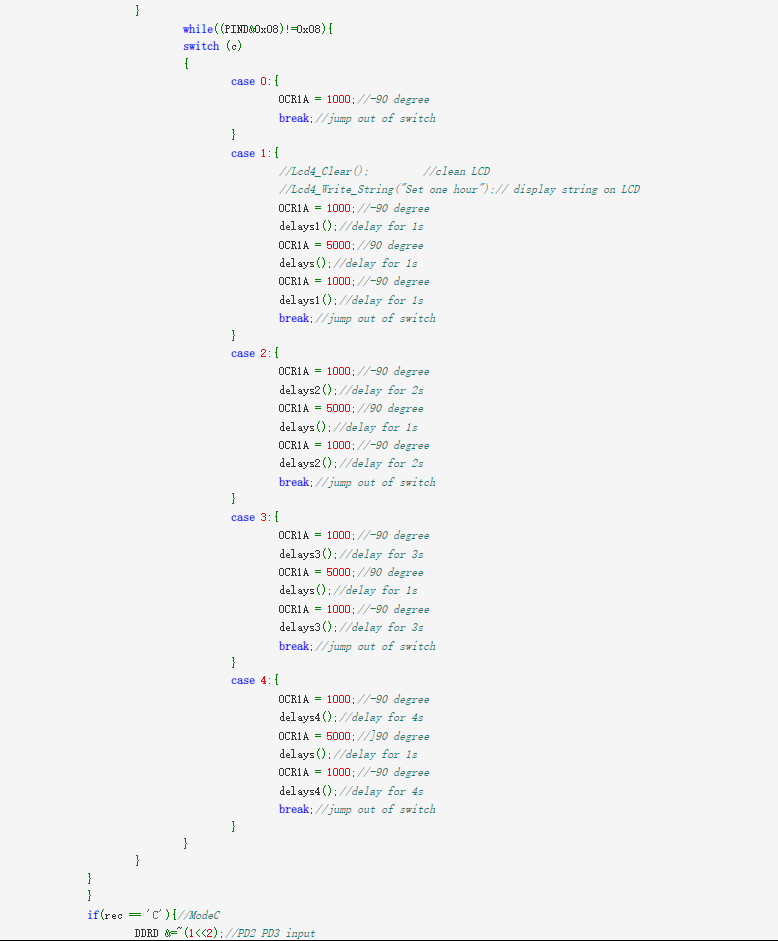
[picture p46: figure]

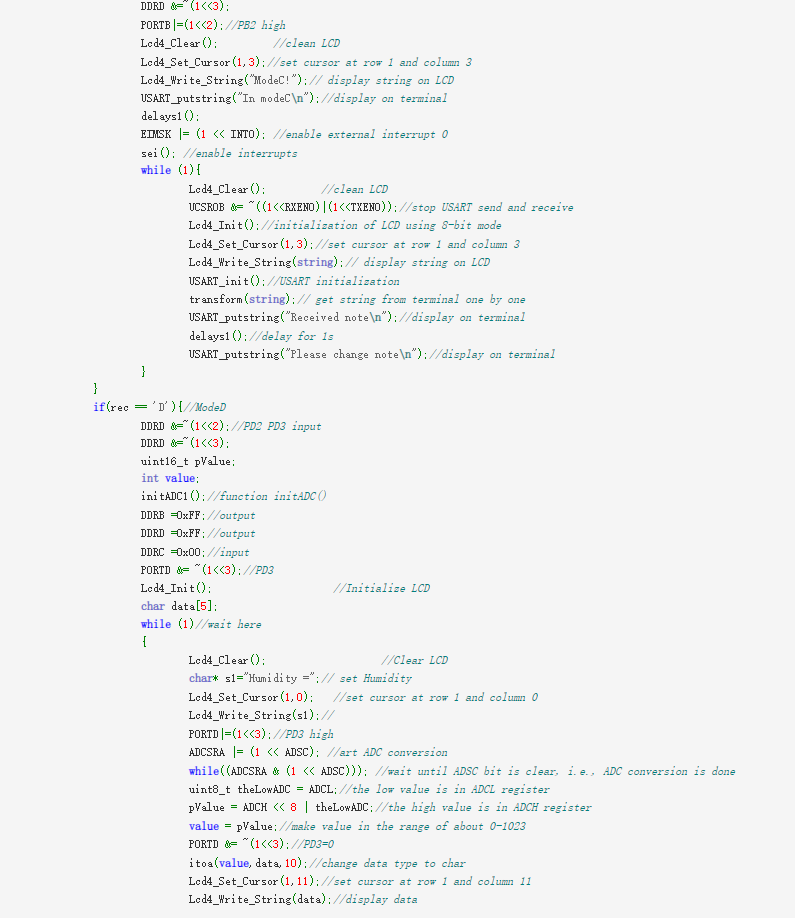
[picture p47: figure]

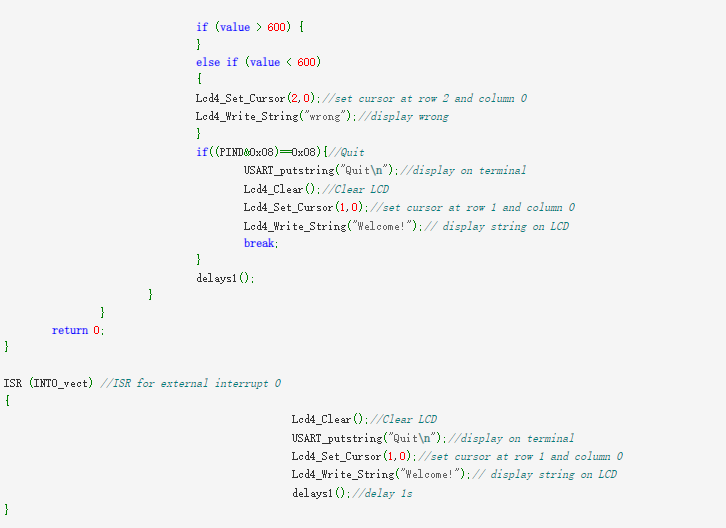
[picture p48: figure]

Here is video for how to use it. I uploaded video on Bilibili and YouTube. YouTube:
https://www.youtube.com/watch?v=lUdwOqK1184
Bilibili:

【B31DD】Miniproject| Cat catering machine| Based on Arduino| H00315680| Yixin

Cao_哔哩哔哩_bilibili (https://www.bilibili.com/video/BV1yq4y1z7kd?spm_id_from=333.999.0.0)
